MikkoTervala/modular-esp32-dimmer/module-4ch-dimmer/jlcpcb/production_files/BOM-module-4ch-dimmer.csv

Comment | Designator | Footprint | LCSC
10µf | C1,C2 | C_1206_3216Metric | C13585
1N5819WS 1A 40V | D1 | D_SOD-323 | C191023
100 | R1,R2,R3,R4 | R_0603_1608Metric | C22775
Conn_01x06_Socket | J1,J2 | PinSocket_1x06_P1.27mm_Vertical_SMD_Pin1Right | C2881496
AON7524 | Q1,Q2,Q3,Q4 | TRANS_AON7403 | C431195
