MikkoTervala/modular-esp32-dimmer/module-4ch-dimmer/module-4ch-dimmer.kicad_pcb

## KiCad design module-4ch-dimmer/module-4ch-dimmer.kicad_pcb (2023-11-27)

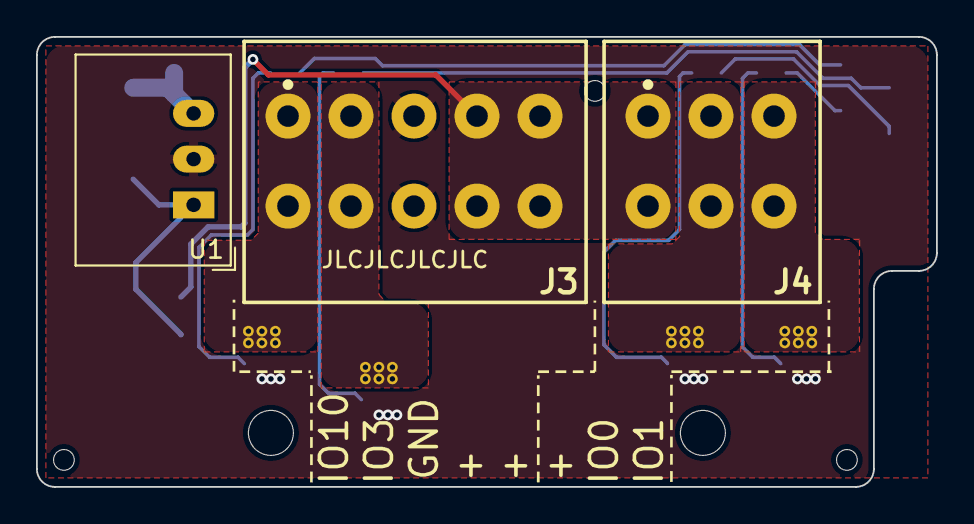
[picture p1: board module-4ch-dimmer.kicad_pcb from above]

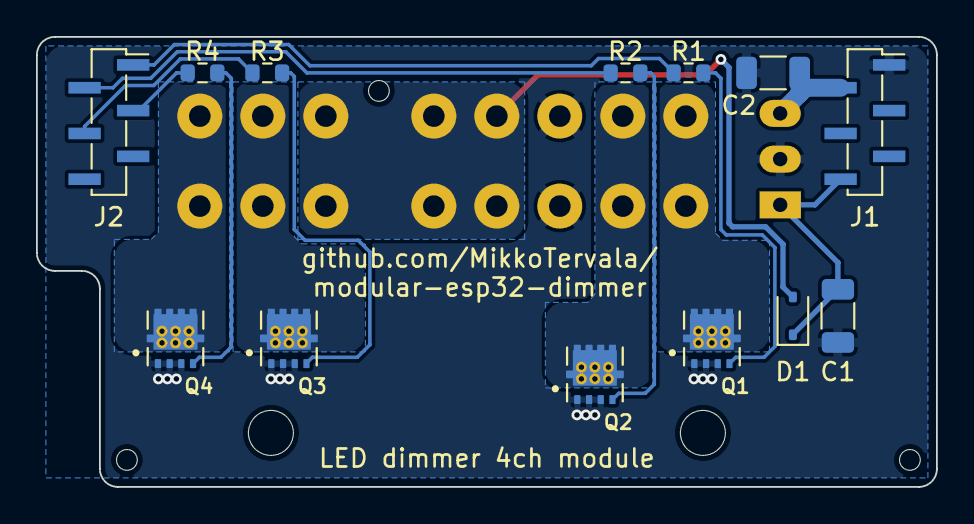
[picture p2: board module-4ch-dimmer.kicad_pcb from below]

Board: 2 copper layers, 50.0 x 25.0 mm, 21 parts (13 on the bottom side), 16 nets.

Parts:
C1, C2: 10µf; C_1206_3216Metric
D1: 1N5819WS 1A 40V; D_SOD-323
H1, H2: MountingHole-Spacer; MountingHole_2.5mm
H3, H4, H5: JLCPCB tooling hole
J1, J2: Conn_01x06_Socket; PinSocket_1x06_P1.27mm_Vertical_SMD_Pin1Right
J3: Conn_01x05; CONN_2601-1105_Wago
J4: Conn_01x03; CONN_2601-1103_Wago
Q1, Q2, Q3, Q4: AON7524; TRANS_AON7403
R1, R2, R3, R4: 100; R_0603_1608Metric
U1: R-78E3.3-0.5; Converter_DCDC_RECOM_R-78E-0.5_THT

Connections:
+3V3: C2.2, J1.2, U1.3 (OUT)
+12C: C1.2, D1.1 (K), J1.6, U1.1 (IN)
+12V: D1.2 (A), J3.4, J3.5, J4.1
/CH1: J3.1, Q1.2 (D)
/CH2: J3.2, Q2.2 (D)
/CH3: J4.2, Q3.2 (D)
/CH4: J4.3, Q4.2 (D)
GND: C1.1, C2.1, J1.1, J3.3, Q1.3 (S), Q2.3 (S), Q3.3 (S), Q4.3 (S), U1.2 (GND)
GPIO0: J2.4, R3.1
GPIO1: J2.3, R4.1
GPIO3: J2.2, R2.1
GPIO10: J2.1, R1.1
unnamed: Q1.1 (G), R1.2
unnamed: Q2.1 (G), R2.2
unnamed: Q3.1 (G), R3.2
unnamed: Q4.1 (G), R4.2
