MikkoTervala/modular-esp32-dimmer/module-esp32/module-esp32.kicad_pcb

## KiCad design module-esp32/module-esp32.kicad_pcb (2023-11-27)

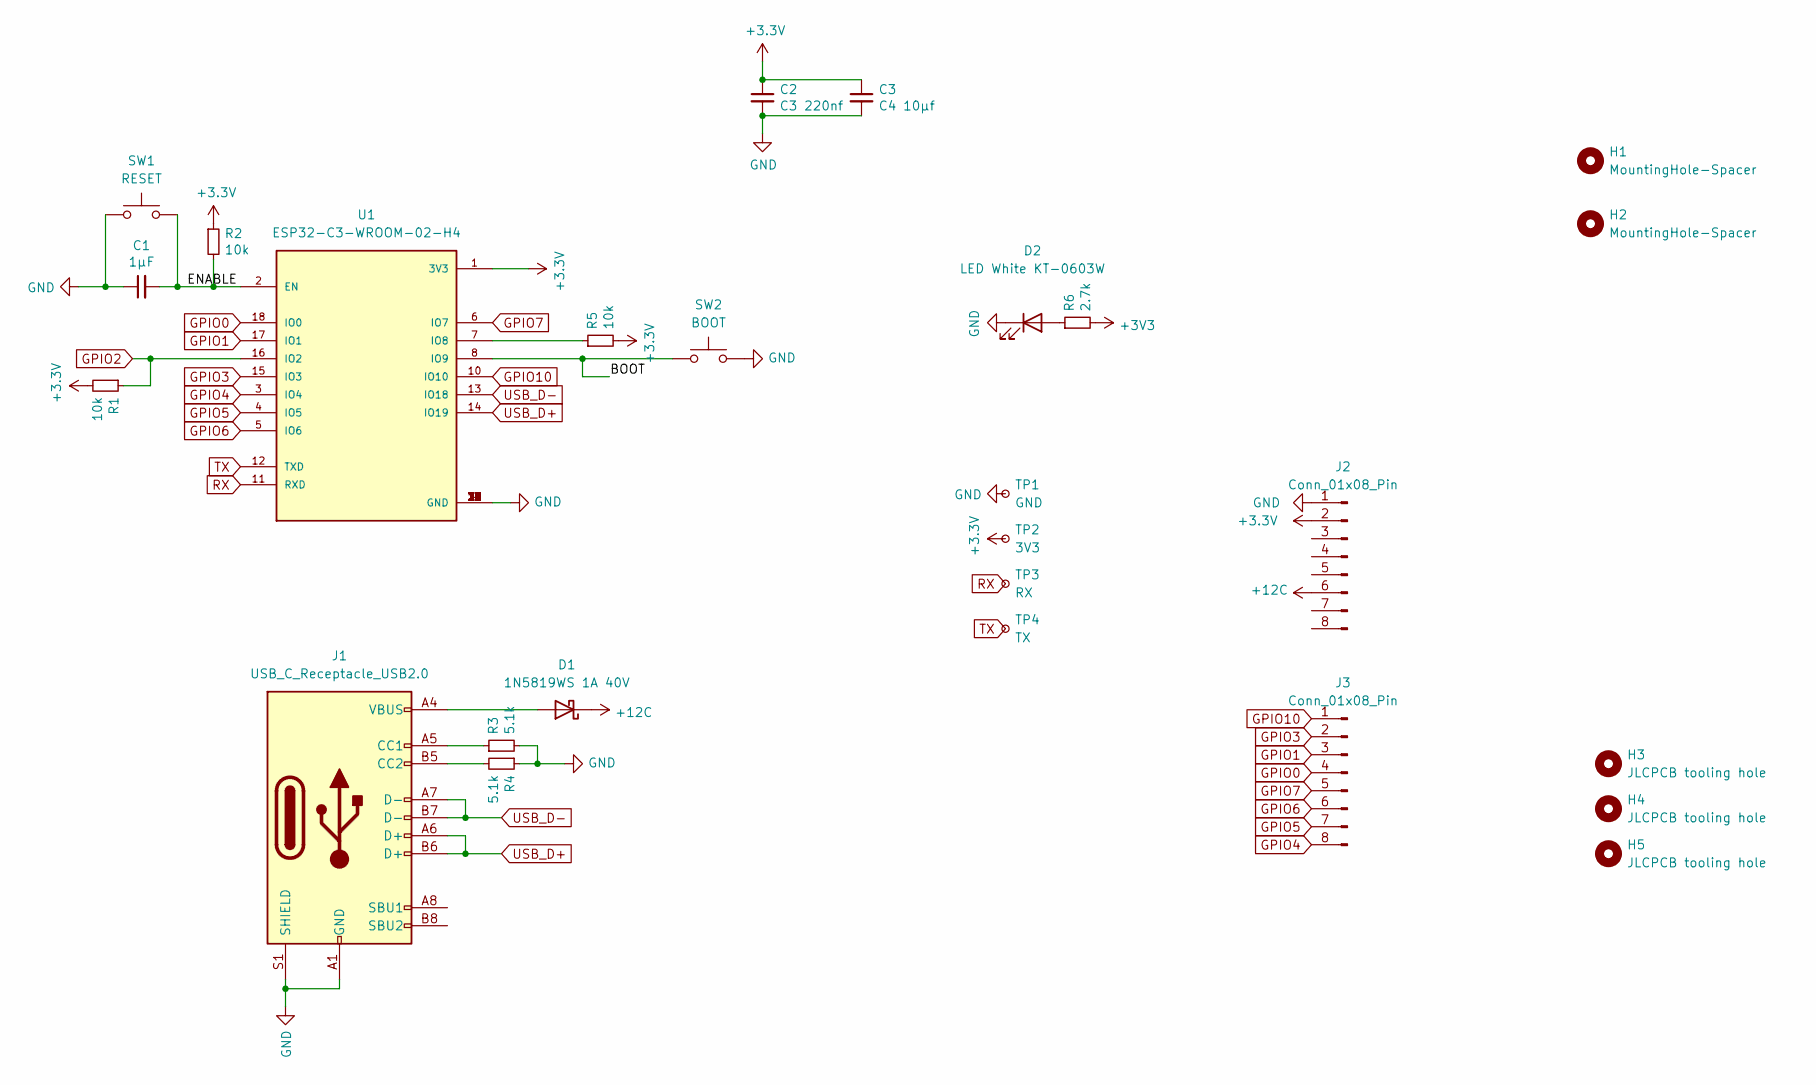
[picture p3: schematic module-esp32.kicad_sch]

Parts:
C1: 1µF; C_0603_1608Metric; LCSC Part # C15849
C2: C3 220nf; C_0603_1608Metric; LCSC Part # C21120
C3: C4 10µf; C_1206_3216Metric; LCSC Part # C13585
D1: 1N5819WS 1A 40V; D_SOD-323; LCSC Part # C191023
D2: LED White KT-0603W; LED_0603_1608Metric; LCSC Part # C2290
H1, H2: MountingHole-Spacer; MountingHole_2.5mm
H3, H4, H5: JLCPCB tooling hole
J1: USB_C_Receptacle_USB2.0; CONN_TYPE-C-31-M-12; LCSC Part # C165948
J2, J3: Conn_01x08_Pin; PinHeader_1x08_P1.27mm_Vertical_SMD_Pin1Right; LCSC Part # C5243492
R1, R2, R5: 10k; R_0603_1608Metric; LCSC Part # C25804
R3, R4: 5.1k; R_0603_1608Metric; LCSC Part # C23186
R6: 2.7k; R_0603_1608Metric; LCSC Part # C13167
SW1: RESET; SW_SPST_PTS810; LCSC Part # C139797
SW2: BOOT; SW_SPST_PTS810; LCSC Part # C139797
TP1: GND; TestPoint_Pad_D1.0mm
TP2: 3V3; TestPoint_Pad_D1.0mm
TP3: RX; TestPoint_Pad_D1.0mm
TP4: TX; TestPoint_Pad_D1.0mm
U1: ESP32-C3-WROOM-02-H4; MODULE_ESP32-C3-WROOM-02-H4; LCSC Part # C2934560

Connections:
+12C: D1.1 (K), J2.6
/BOOT: SW2.1, U1.8 (IO9)
/ENABLE: C1.2, R2.2, SW1.2, U1.2 (EN)
GND: C1.1, C2.2, C3.2, D2.1 (K), J1.A1 (GND), J1.A12 (GND), J1.B1 (GND), J1.B12 (GND), J1.S1 (SHIELD), J2.1, R3.2, R4.1, SW1.1, SW2.2, TP1.1, U1.9 (GND), U1.19 (GND), U1.20 (GND), U1.21 (GND), U1.22 (GND), U1.23 (GND), U1.24 (GND), U1.25 (GND), U1.26 (GND), U1.27 (GND), U1.28 (GND), U1.29 (GND), U1.30 (GND), U1.31 (GND), U1.32 (GND), U1.33 (GND), U1.34 (GND), U1.35 (GND), U1.36 (GND), U1.37 (GND), U1.38 (GND), U1.39 (GND)
GPIO0: J3.4, U1.18 (IO0)
GPIO1: J3.3, U1.17 (IO1)
GPIO2: R1.1, U1.16 (IO2)
GPIO3: J3.2, U1.15 (IO3)
GPIO4: J3.8, U1.3 (IO4)
GPIO5: J3.7, U1.4 (IO5)
GPIO6: J3.6, U1.5 (IO6)
GPIO7: J3.5, U1.6 (IO7)
GPIO10: J3.1, U1.10 (IO10)
unnamed: D1.2 (A), J1.A4 (VBUS), J1.A9 (VBUS), J1.B4 (VBUS), J1.B9 (VBUS)
unnamed: D2.2 (A), R6.1
unnamed: J1.A5 (CC1), R3.1
unnamed: J1.B5 (CC2), R4.2
unnamed: R5.1, U1.7 (IO8)
RX: TP3.1, U1.11 (RXD)
TX: TP4.1, U1.12 (TXD)
USB_D+: J1.A6 (D+), J1.B6 (D+), U1.14 (IO19)
USB_D-: J1.A7 (D-), J1.B7 (D-), U1.13 (IO18)

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
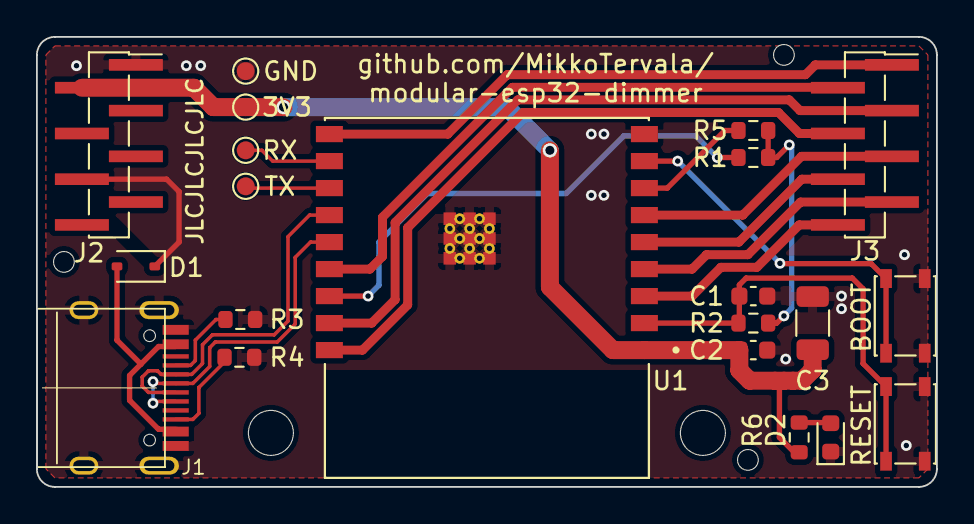
[picture p4: board module-esp32.kicad_pcb from above]

Board: 2 copper layers, 50.0 x 25.0 mm, 26 parts (0 on the bottom side), 23 nets.
